jay-hamlin/rpncalculator/README.md

# rpncalculator
RPN Calculator inspired by the HP-97
