jay-hamlin/rpncalculator/Hardware/RPNCalc_BOM_1208.ods

Source: | /Users/jayhamlin/Documents/KiCAD_Projects/RPN_Calc/RPN_calc_TOPsch.sch
Date: | 12/08/20
Tool: | Eeschema (5.1.6-0-10_14)
Generator: | /private/var/folders/gj/cw4xhsdd5xb5fvtbn493dk5w0000gn/T/AppTranslocation/25B9B632-5422-4884-8414-362C2BAEAF93/d/kicad.app/Contents/SharedSupport/plugins/bom_csv_grouped_by_value_with_fp.py
Component Count:
Ref | Qty | Value | Cmp name | Footprint | Description | Manufacturer | MPN | Digikey PN | ordered | buildable qty | $$
C201, C203, C207, C209, C213, C215, C301, C403, C406, C407, C408, C409, C410, C412, C413, C414, C415, C416, C418, C419, C420, C507, C509, | 23 | 100nF | C | C_0603 | CAP CER 0.1UF 25V X7R 0603 | AVX | 06033C104KAT4A | 478-7018-1-ND | 100 | 4.3 | $1.89
C202, C204, C208, C210, C214, C216, C411, C502, | 8 | 1uF | C | C_0603 | CAP CER 1UF 16V X7R 0603 | AVX | 0603YC105KAT4A | 478-10815-1-ND | 50 | 6.3 | $4.08
C205, C206, C401, C402, | 4 | 4.7uF | C_Small | C_0805 | CAP CER 4.7UF 16V X7R 0805 | AVX | 0805YC475KAT2A | 478-5722-1-ND | 25 | 6.3 | $5.40
C404, C405, | 2 | 20pF | C_Small | C_0402 | CAP CER 20PF 50V NP0 0402 | AVX | 04025U200FAT2A | 478-10147-1-ND | 8 | 4.0 | $2.51
C417, C503, C504, C508, | 4 | 10uF | C | C_1206 | CAP CER 10UF 16V X7R 1206 | AVX | 1206YC106KAT2A | 478-5725-1-ND | 22 | 5.5 | $8.61
C501, | 1 | 33uF | CP1_Small | C_Radial_D5.0mm_H11.0mm_P2.00mm | CAP ALUM 33UF 20% 25V RADIAL | Nichicon | UPW1E330MDD | 493-1814-ND | 2 | 2.0 | $2.55
C505, | 1 | 7.0pF | C | C_0402 | CAP CER 7PF 50V NP0 0402 | AVX | 04025A7R0CAT2A | 478-10114-1-ND | 8 | 8.0 | $0.41
C506, | 1 | 33pF | C | C_0402 | CAP CER 33PF 25V C0G/NP0 0402 | AVX | 04023A330JAT2A | 478-12613-1-ND | 8 | 8.0 | $0.30
D1, D2, D3, D4, | 4 | LED | LED | LED_THT_D3.0mm | LED RED DIFFUSED 3MM ROUND T/H | Wurth | 151031SS06000 | 732-5006-ND | 29 | 7.3
D401, D402, D403, | 3 | LED | LED | LED_1206 | LED RED CLEAR 1206 SMD | Lite-On Inc. | LTST-C150CKT | 160-1167-1-ND | 90 | 30.0
D501, | 1 | CDBU0240 | D | D_0603 | DIODE SCHOTTKY 40V 200MA 0603 | Comchip | CDBU0240 | 641-1009-1-ND | 8 | 8.0 | $2.80
F401, F402, | 2 | Polyfuse_Small | Polyfuse_Small | Fuse_1206 | PTC RESET FUSE 13.2V 500MA 1206 | Littlefuse, Inc. | NANOSMDC050F/13.2-2 | NANOSMDC050F/13.2-2CT-ND | 1 | 0.5 |  | buy more
FB401, | 1 | Ferrite_Bead_Small | Ferrite_Bead_Small | L_0805 | FERRITE BEAD 600 OHM 0805 1LN | Vishay | ILBB0805ER601V | 541-2297-1-ND | 8 | 8.0 | $0.75
J201, J202 | 2 | Conn_01x04 | Conn_01x04_FEMALE | PinHeader_1x04_P2.54mm_Vertical FEMALE | CONN HDR 4POS 0.1 GOLD PCB | Sullins | PPPC041LFBN-RC | S7037-ND | 8 | 4.0 | $4.37
J401, J402, | 2 |  | Conn_01x04_MALE | PinHeader_1x04_P2.54mm_Vertical MALE | CONN HEADER VERT 4POS 2.54MM | Wurth | 61300411121 | 732-5317-ND | 8 | 4.0
J203, J204, | 2 | Conn_01x02 | Conn_01x02_FEMALE | PinHeader_1x02_P2.54mm_Vertical FEMALE | CONN HDR 2POS 0.1 GOLD PCB | Sullins | PPPC021LFBN-RC | S7035-ND | 8 | 4.0 | $3.15
J403, J404, | 2 |  | Conn_01x02_Male | PinHeader_1x02_P2.54mm_Vertical MALE | CONN HEADER VERT 2POS 2.54MM | Wurth | 61300211121 | 732-5315-ND | 8 | 4.0
J405, | 1 | Conn_02x03_Odd_Even | Conn_02x03_Odd_Even | PinHeader_2x03_P2.54mm_Vertical MALE | CONN HEADER VERT 6POS 2.54MM | Wurth | 61300621121 | 732-5295-ND | 8 | 8.0
J406, J407, | 2 | USB_B_Micro | USB_B_Micro | USB_Micro-B_Molex-105017-0001 | CONN RCPT USB2.0 MICRO B SMD R/A | Molex | 1050170001 | WM1399CT-ND | 4 | 2.0 | $4.98
J501, | 1 | JST PTH 2.0mm vertical | Conn_01x02_Male | JST_PH_B2B-PH-K_1x02_P2.00mm_Vertical | CONN HEADER VERT 2POS 2MM | JST Sales | B2B-PH-K-S(LF)(SN) | 455-1704-ND | 10 | 10.0 | $0.85
L501, | 1 | 2.2uH | L_Small | L_Bourns-SRN4018 | FIXED IND 2.2UH 2.9A 44 MOHM SMD | Bourns | SRN4018-2R2M | SRN4018-2R2MCT-ND | 4 | 4.0 | $2.20
LD1, LD2, LD3, LD4, LD5, LD6, LD7, LD8, LD9, LD10, LD11, LD12, | 12 | LTP-305HR | LTP-305HR | LTP-305HR_DIP14 | DISPLAY DOT MATRX HER 0.30" 5X7 | Lite-On Inc. | LTP-305HR | 160-1881-ND | 12 | 1.0
Q501, Q503, | 2 | MMBT3906 | 2N3906 | SOT-23 | TRANS PNP 40V 0.2A SOT-23 | MMC | MMBT3906-TP | MMBT3906-TPCT-ND | 8 | 4.0 | $1.18
Q502, | 1 | 2N7002 | 2N7002 | SOT-23 | MOSFET N-CH 60V 115MA SOT-23 | ON Semiconductor | 2N7002 | 2N7002NCT-ND | 20 | 20.0 | $2.63
R402, R403, R404, R405,R504 | 5 | 2.2K | R_Small_US | R_0603 | RES SMD 2.2K OHM 1% 1/10W 0603 | Panasonic | ERJ-3EKF2201V | P2.20KHCT-ND | 90 | 18.0 | $1.30
R205, R206, R207, R208, R408, R409, R421, R422, | 8 | 20R | R_Small_US | R_0402 | RES SMD 20 OHM 1% 1/10W 0402 | Panasonic | ERJ-2RKF20R0X | P20.0LCT-ND | 90 | 11.3 | $0.89
R301, R302, R303, R304, R305, R306, R307, R308, R411, R423, R425, R501, R502, R503, R505,R506, R507, R509,R511, R513 | 20 | 100K | R_Small_US | R_0603 | RES SMD 100K OHM 1% 1/10W 0603 | Yageo | RC0603FR-07100KL | 311-100KHRCT-ND | 100 | 5.0 | $0.85
R401 | 1 | 10K | R_Small_US | R_0603 | RES SMD 10K OHM 1% 1/10W 0603 | Panasonic | ERJ-3EKF1002V | P10.0KHCT-ND | 90 | 90.0 | $1.30
R406, R407, R412, R413, R414, R419, R420, R508, R510 | 9 | 1K | R_Small_US | R_0603 | RES SMD 1K OHM 1% 1/10W 0603 | Panasonic | ERJ-3EKF1001V | P1.00KHCT-ND | 100 | 11.1 | $1.30
R410, | 1 | 240R | R_Small_US | R_0603 | RES SMD 240 OHM 1% 1/10W 0603 | Panasonic | ERJ-3EKF2400V | P240HCT-ND | 90 | 90.0 | $0.32
R427 | 1 | 200K | R_Small_US | R_0603 | RES SMD 200K OHM 1% 1/10W 0603 | Panasonic | ERJ-3EKF2003V | P200KHCT-ND | 100 | 100.0
R512 | 1 | 499K,1% | R_Small_US | R_0603 | RES SMD 499K OHM 1% 1/10W 0603 | Panasonic | ERJ-3EKF4993V | P499KHCT-ND | 20 | 20.0
R415 | 1 | 549K,1% | R_Small_US | R_0603 | RES SMD 549K OHM 1% 1/10W 0603 | Panasonic | ERJ-3EKF5493V | P549KHCT-ND | 100 | 100.0 | $0.80
R424, R426 | 2 | 604K,1% | R_Small_US | R_0603 | RES SMD 604K OHM 1% 1/10W 0603 | Panasonic | ERJ-3EKF6043V | P604KHCT-ND | 100 | 50.0
R417 | 1 | 1.00M,1% | R_Small_US | R_0603 | RES SMD 1M OHM 1% 1/4W 0603 | Panasonic | ERJ-PA3F1004V | P1.0MBYCT-ND | 100 | 100.0 | $1.13
R416, R418 | 2 | 2.00M,1% | R_Small_US | R_0603 | RES SMD 2M OHM 1% 1/10W 0603 | Panasonic | ERJ-3EKF2004V | P2.00MHCT-ND | 100 | 50.0
RV401, | 1 | 50K, linear | R_POT_Small | Potentiometer_Bourns_3266Y_Vertical | THUMBWHEEL POT 50K OHM 0.5W SIDE | Bourns | 3352W-1-503LF | 3352W-503LF-ND | 2 | 2.0 | $10.75
SW1_BASE1, SW2_DSP1, SW3_C1, SW4_D1, SW5_E1, SW6_F1, SW7_/1, SW8_SEND1, SW9_CHS1, SW10_B1, SW11_7, SW12_8, SW13_9, SW14_X1, SW15_COPY1, SW16_ROL1, SW17_A1, SW18_4, SW19_5, SW20_6, SW21_-1, SW22_PASTE1, SW23_X-Y1, SW24_MOD1, SW25_1, SW26_2, SW27_3, SW28_+1, SW29_func1, SW30_R1, SW31_<-1, SW32_0, SW33_.1, SW34_ENTER1, | 34 | TL1105SPF | TL1105SPF | Button_Switch_THT:SW_PUSH_TL1105 | SWITCH TACTILE SPST-NO 0.05A 12V | E-Switch | TL1105SPF100Q | EG2502-ND | 60
SW501, | 1 | 1-1825027-1 | 1-1825027-1 | Button_Switch_THT:SW_Tactile_SPST_Angled_PTS645Vx58-2LFS | SWITCH TACTILE SPST-NO 0.05A 24V | TE | 1-1825027-1 | 450-1658-ND | 2 | 2.0
TH501, | 1 | 10K, NTC | Thermistor_NTC | R_0603 | THERMISTOR NTC 10KOHM 3477K 0603 | Vishay | NTHS0603N02N1002JE | 541-1107-1-ND | 2 | 2.0
U1, U2, U3, U4, U5, U6, | 6 | IS31FL3730-QFN24 | IS31FL3730-QFN24 | QFN-24-1EP_4x4mm_P0.5mm_EP2.7x2.7mm | IC MATRIX LED DRIVER AUDIO 24QFN | Lumissil | IS31FL3730-QFLS2-TR | 706-1479-1-ND | 12 | 2.0
U301, | 1 | TCA8418RTWR | TCA8418RTWR | WQFN-24-1EP_4x4mm_P0.5mm_EP2.6x2.6mm | IC INTERFACE SPECIALIZED 24WQFN | TI | TCA8418RTWR | 296-25223-1-ND | 2 | 2.0
U401, | 1 | STM32F070CBTx | STM32F070CBTx | LQFP-48_7x7mm_P0.5mm | IC MCU 32BIT 32KB FLASH 48LQFP | ST Micro | STM32F070C6T6TR | 497-18744-1-ND | 2 | 2.0
U402, U403, | 2 | W25Q128JVS | W25Q128JVS | SOIC-8_5.23x5.23mm_P1.27mm | IC FLASH 128M SPI 133MHZ 8SOIC | Winbond | W25Q128JVSIQ TR | W25Q128JVSIQCT-ND | 4 | 2.0
U404, | 1 | FT231XS | FT231XS | SSOP-20_3.9x8.7mm_P0.635mm | IC USB SERIAL FULL UART 20SSOP | FTDI | FT231XS-R | 768-1129-1-ND | 1 | 1.0 | 1
U405, | 1 | MCP6422T-E/SN | MCP6422T-E/SN | SOIC-8_3.9x4.9mm_P1.27mm | IC OPAMP GP 2 CIRCUIT 8SOIC | Microchip | MCP6422T-E/SN | MCP6422T-E/SNCT-ND | 10 | 10.0 | 3
U501, | 1 | MCP73833T-FCI_MF | MCP73833T-FCI_MF | DFN-10-1EP_3x3mm_P0.5mm_EP1.7x2.5mm | IC LI-ION/LI-POLY CTRLR 10DFN | Microchip | MCP73833T-FCI/MF | MCP73833T-FCI/MFCT-ND | 2 | 2.0
U502, | 1 | LM3671MF | LM3671MF | TSOT-23-5 | IC REG BUCK ADJ 600MA SOT23-5 | TI | LM3671MF-ADJ/NOPB | LM3671MF-ADJ/NOPBCT-ND | 2 | 2.0
Y401, | 1 | 8MHz(12pF) | Crystal | HC49-SD | CRYSTAL 8.0000MHZ 12PF SMD | TXC | 9C-8.000MAAE-T | 887-2473-1-ND | 2 | 2.0
 |  |  |  |  |  |  |  |  | Total=
