jay-hamlin/rpncalculator/(list of files, cad)

Other CAD files:
Mechanical/rpnkeys2.scad
Mechanical/rpnkeys_1230am.scad
Mechanical/rpnkeys_frame.scad
