jay-hamlin/rpncalculator/Hardware/RPN_calc_TOPsch.pdf

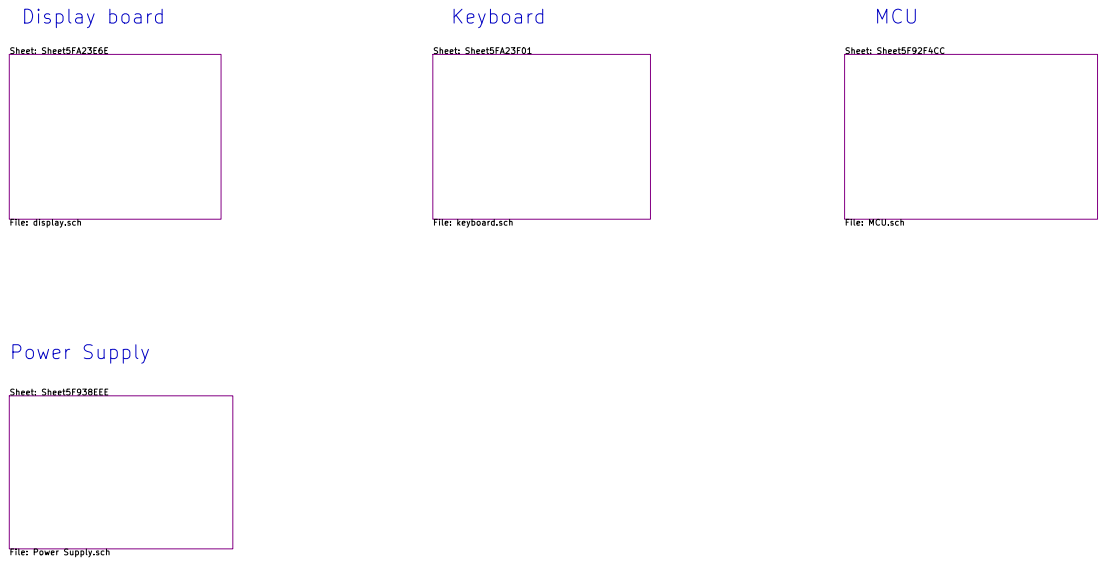
[picture p1: page 1]

File: MCU.sch Sheet: Sheet5F938EEE

File: Power Supply.sch

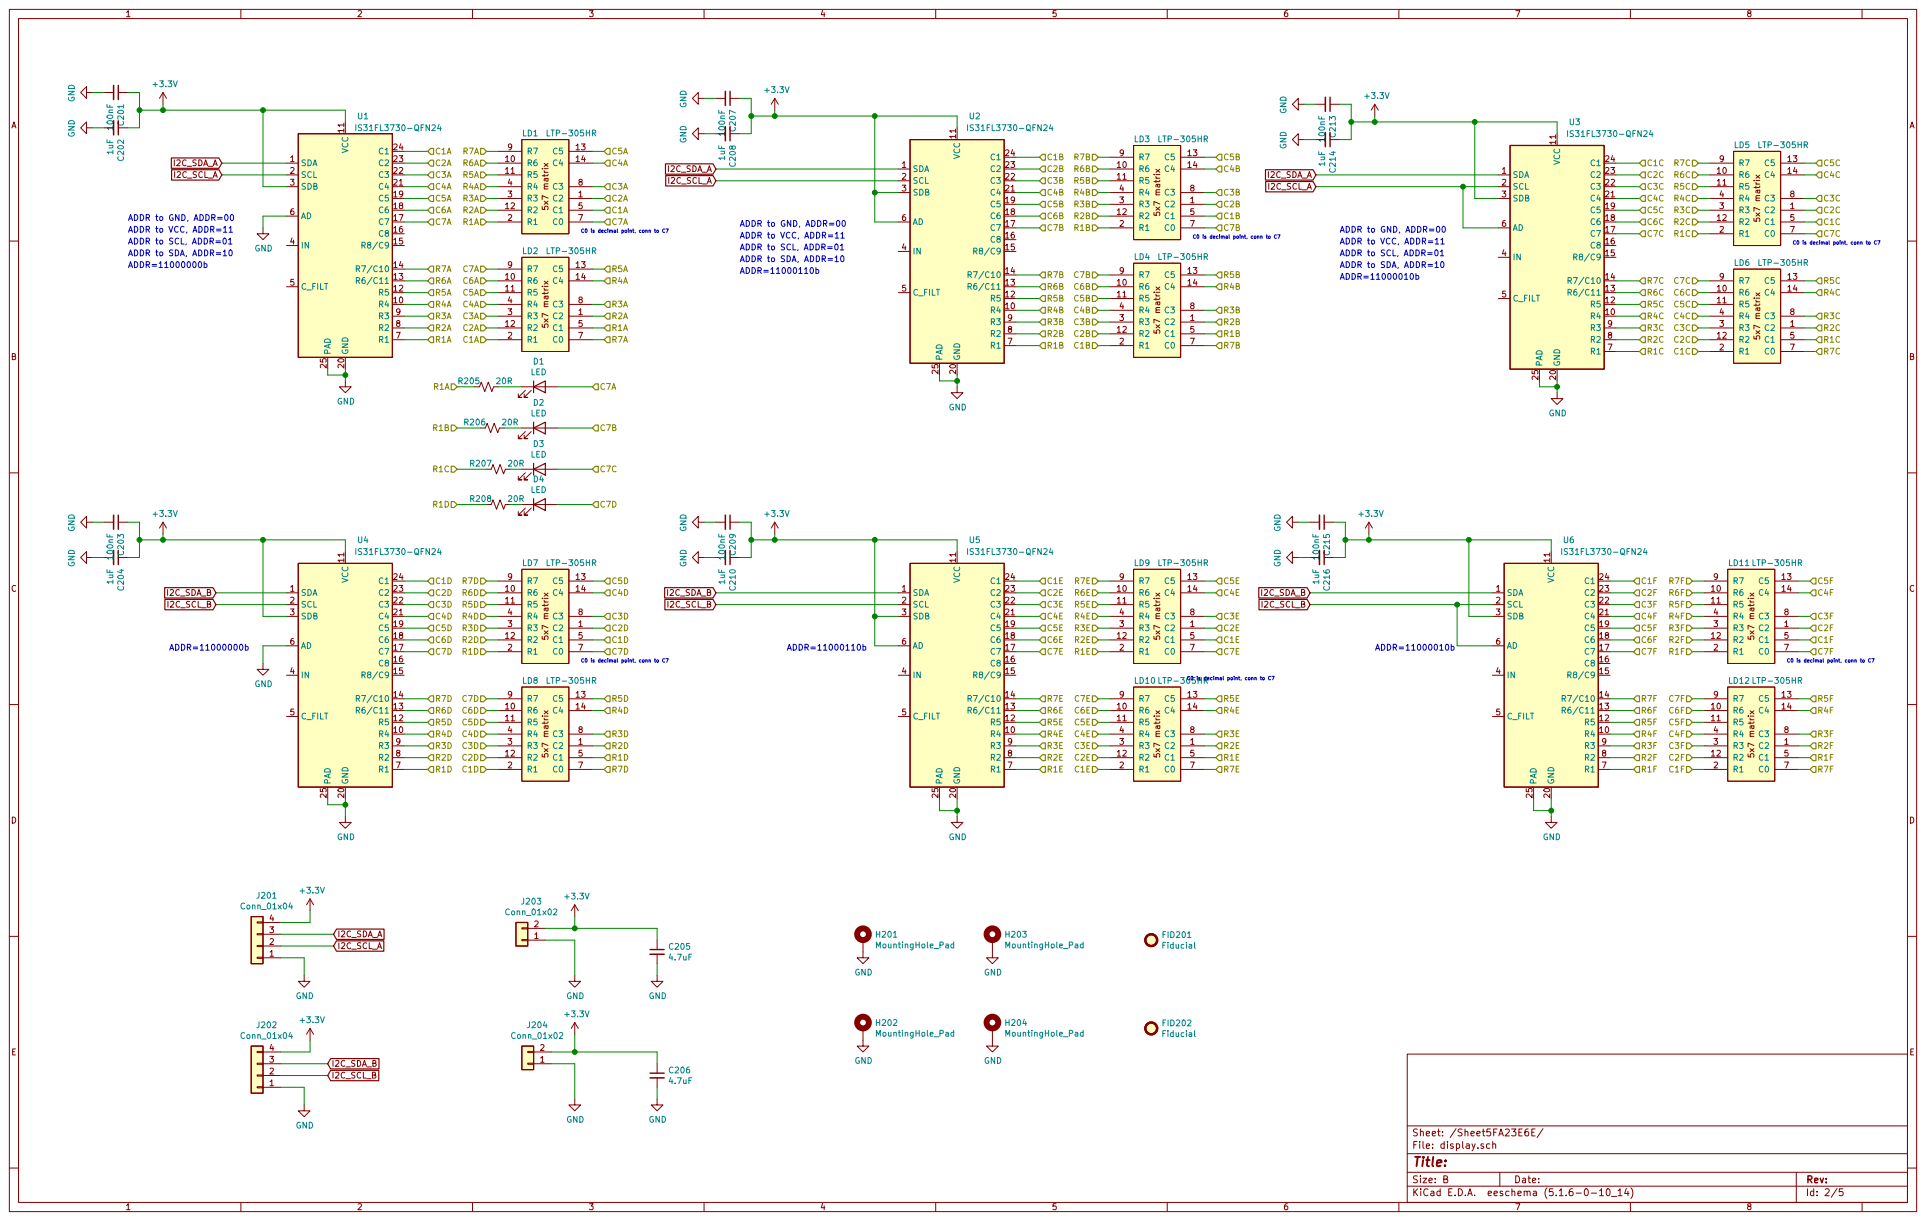
[picture p2: page 2]

ADDR to SCL, ADDR=01 ADDR to GND, ADDR=00
ADDR to SDA, ADDR=10 ADDR to VCC, ADDR=11 ADDR to SCL, ADDR=01

C0 is decimal point, conn to C7

File: display.sch Sheet: /Sheet5FA23E6E/

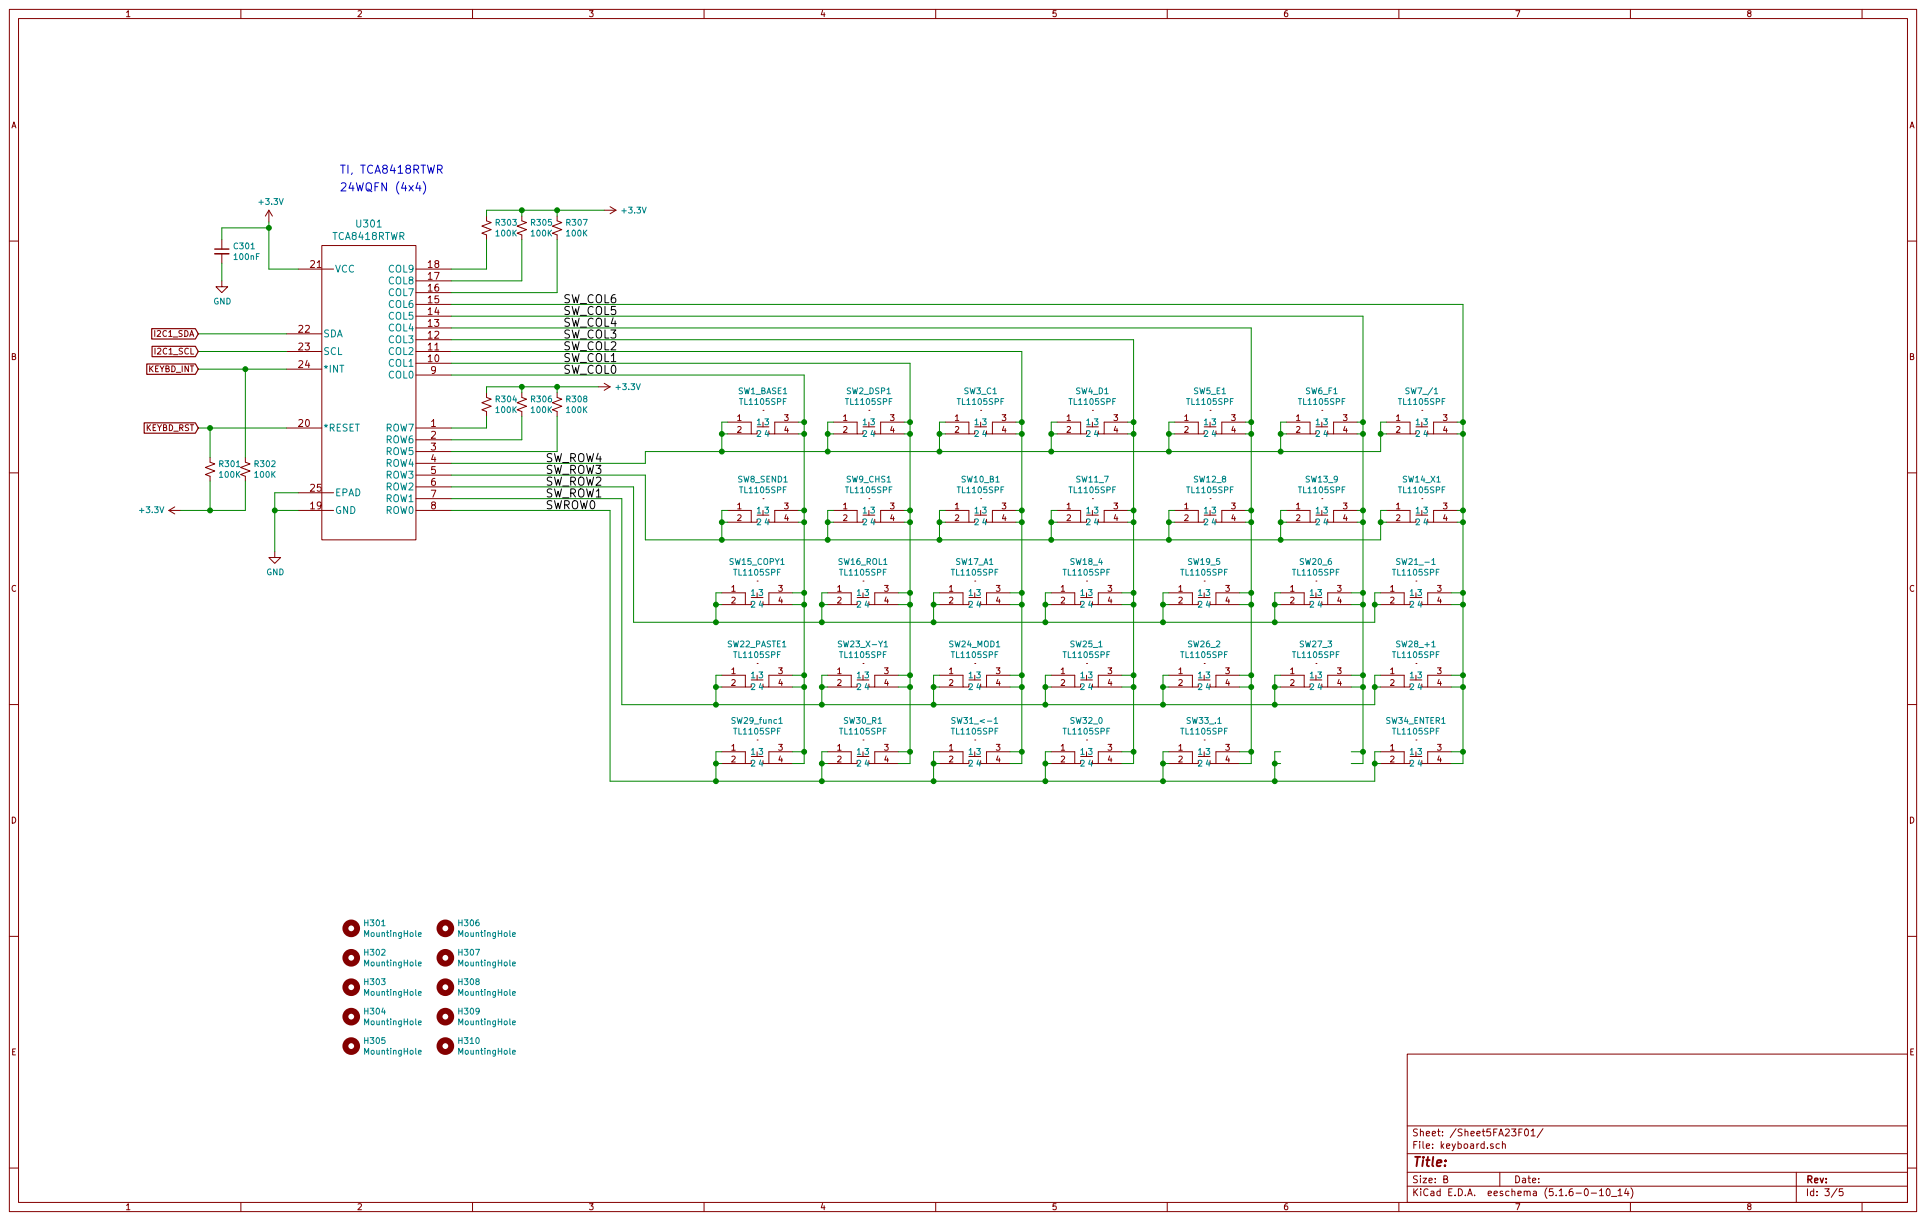
[picture p3: page 3]

SW_COL5
SW_COL4
SW_COL3
SW_COL2
SW_COL1
SW_COL0

4 SW9_CHS1 TL1105SPF 1 3 | 4 SW10_B1 TL1105SPF 1 3 | 4 SW11_7 TL1105SPF 1 3 | 4 SW12_8 TL1105SPF 1 3 | 4 SW13_9 TL1105SPF 1 3

File: keyboard.sch Sheet: /Sheet5FA23F01/

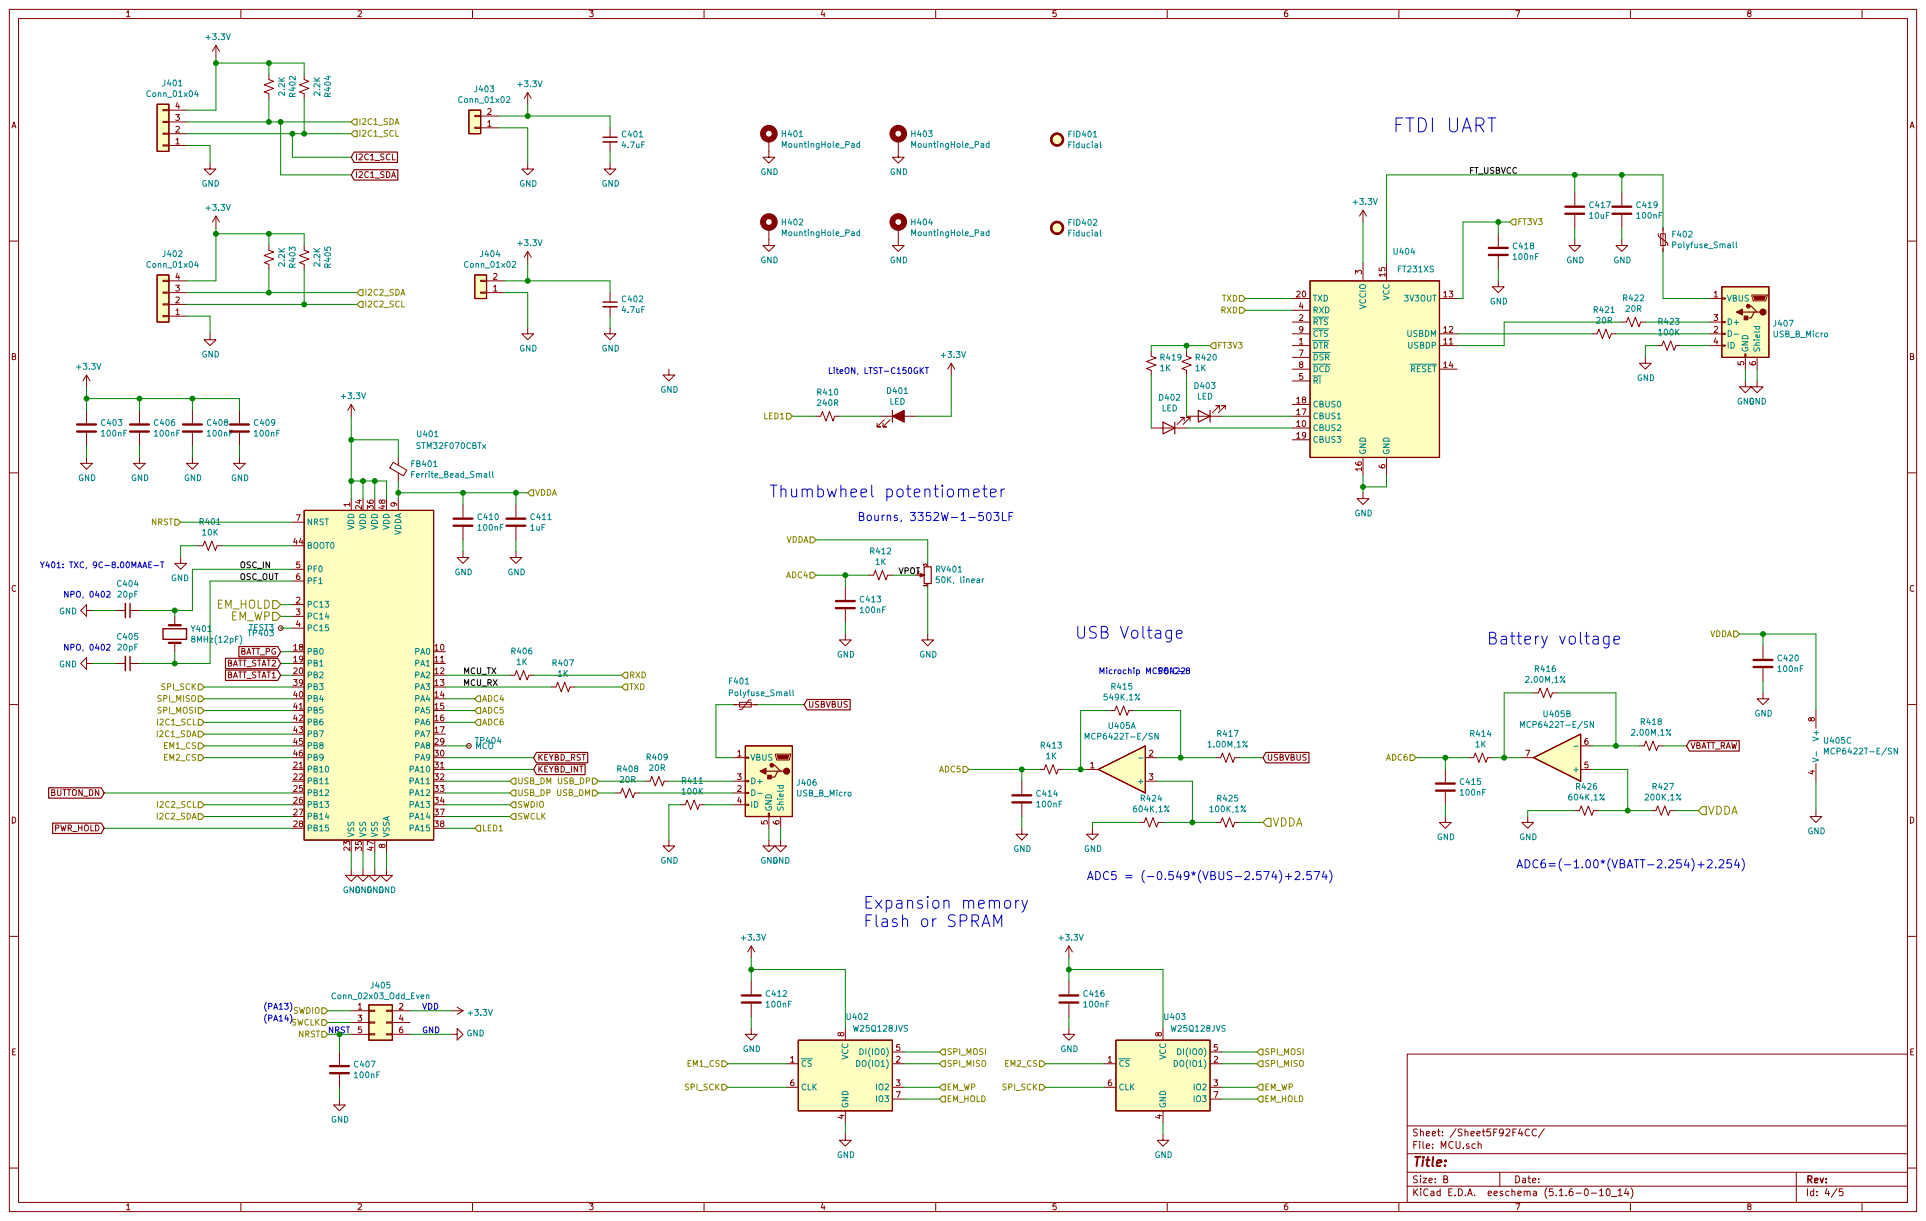
[picture p4: page 4]

1 PA0 10 PA1 11 PA2 12 PA3 13 PA4 14 PA5 15 PA6 16 PA7 17 PB0 18 PB1 19 PC13 2 PB2 20 PB10 21 PB11 22 VSS 23 VDD 24 PB12 25 PB13 26 PB14 27 PB15 28 PA8 29 PC14 3 PA9 30 PA10 31 PA11 32 PA12 33 PA13 34 VSS 35 VDD 36 PA14 37 PA15 38 PB3 39 PC15 4 PB4 40 PB5 41 PB6 42 PB7 43 BOOT0 44 PB8 45 PB9 46 VSS 47 VDD 48 PF0 5 PF1 6 NRST 7 VSSA

Id: 4/5 Title: File: MCU.sch Sheet: /Sheet5F92F4CC/

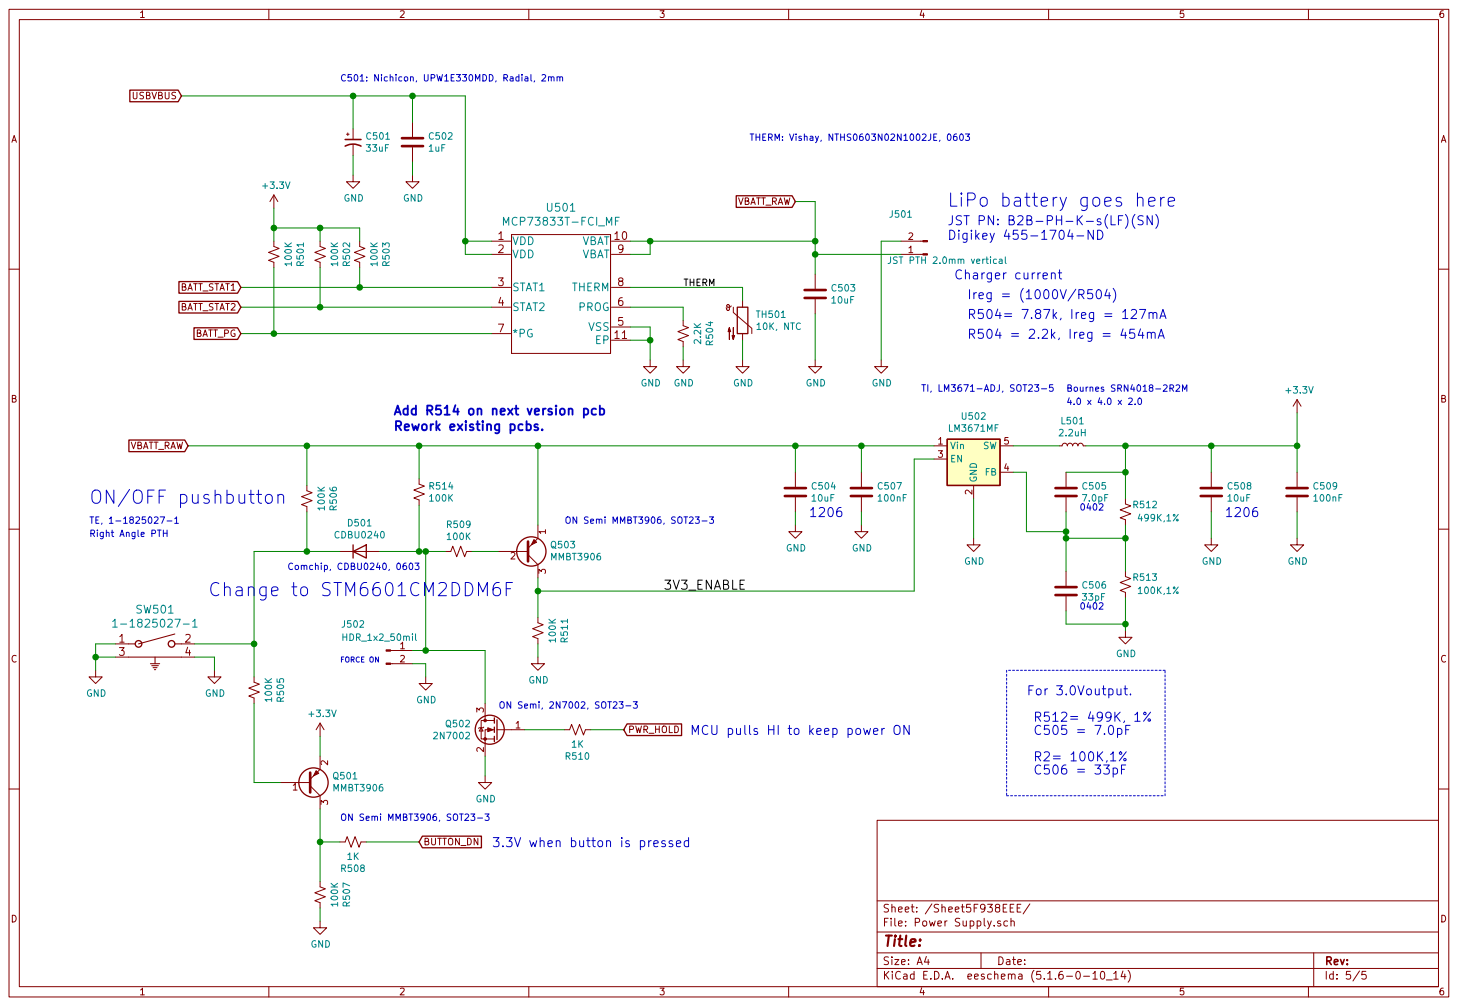
[picture p5: page 5]

JST PN: B2B-PH-K-s(LF)(SN)
Digikey 455-1704-ND

+3.3V GND
Add R514 on next version pcb
Rework existing pcbs.

0402 TI, LM3671-ADJ, SOT23-5 MCU pulls HI to keep power ON

FORCE ON ON/OFF pushbutton

3.3V when button is pressed
