jay-hamlin/rpncalculator/Hardware/RPN_Calc.kicad_pcb

## KiCad design Hardware/RPN_Calc.kicad_pcb (2020-12-23)

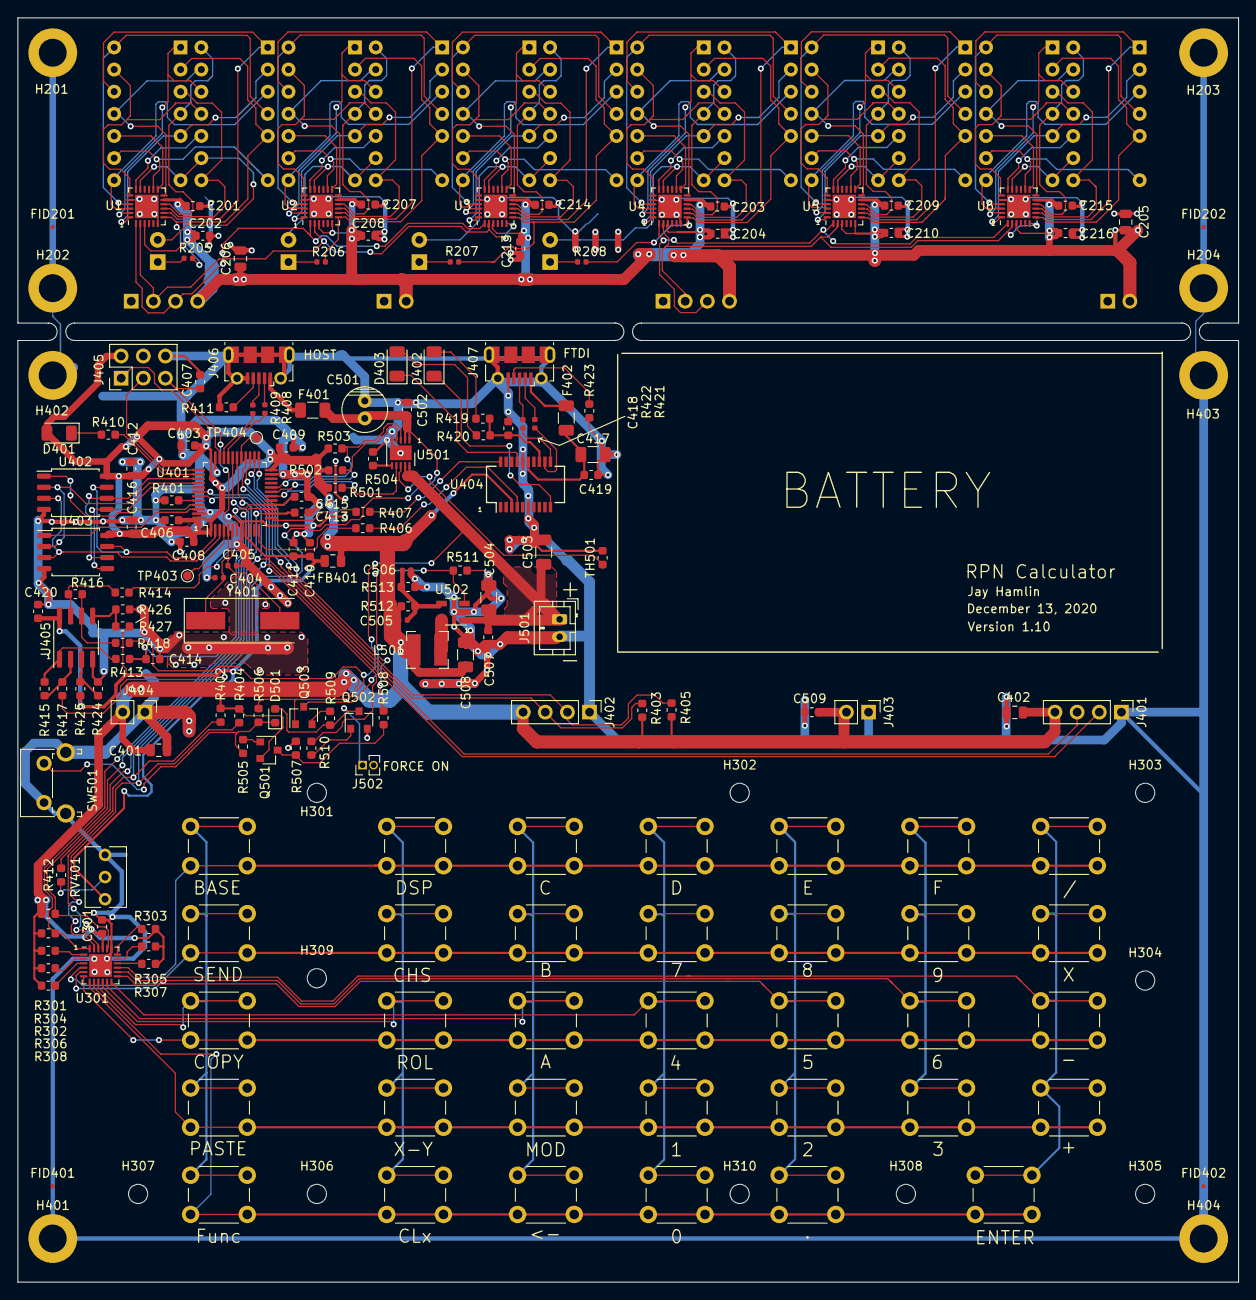
[picture p6: board RPN_Calc.kicad_pcb from above]

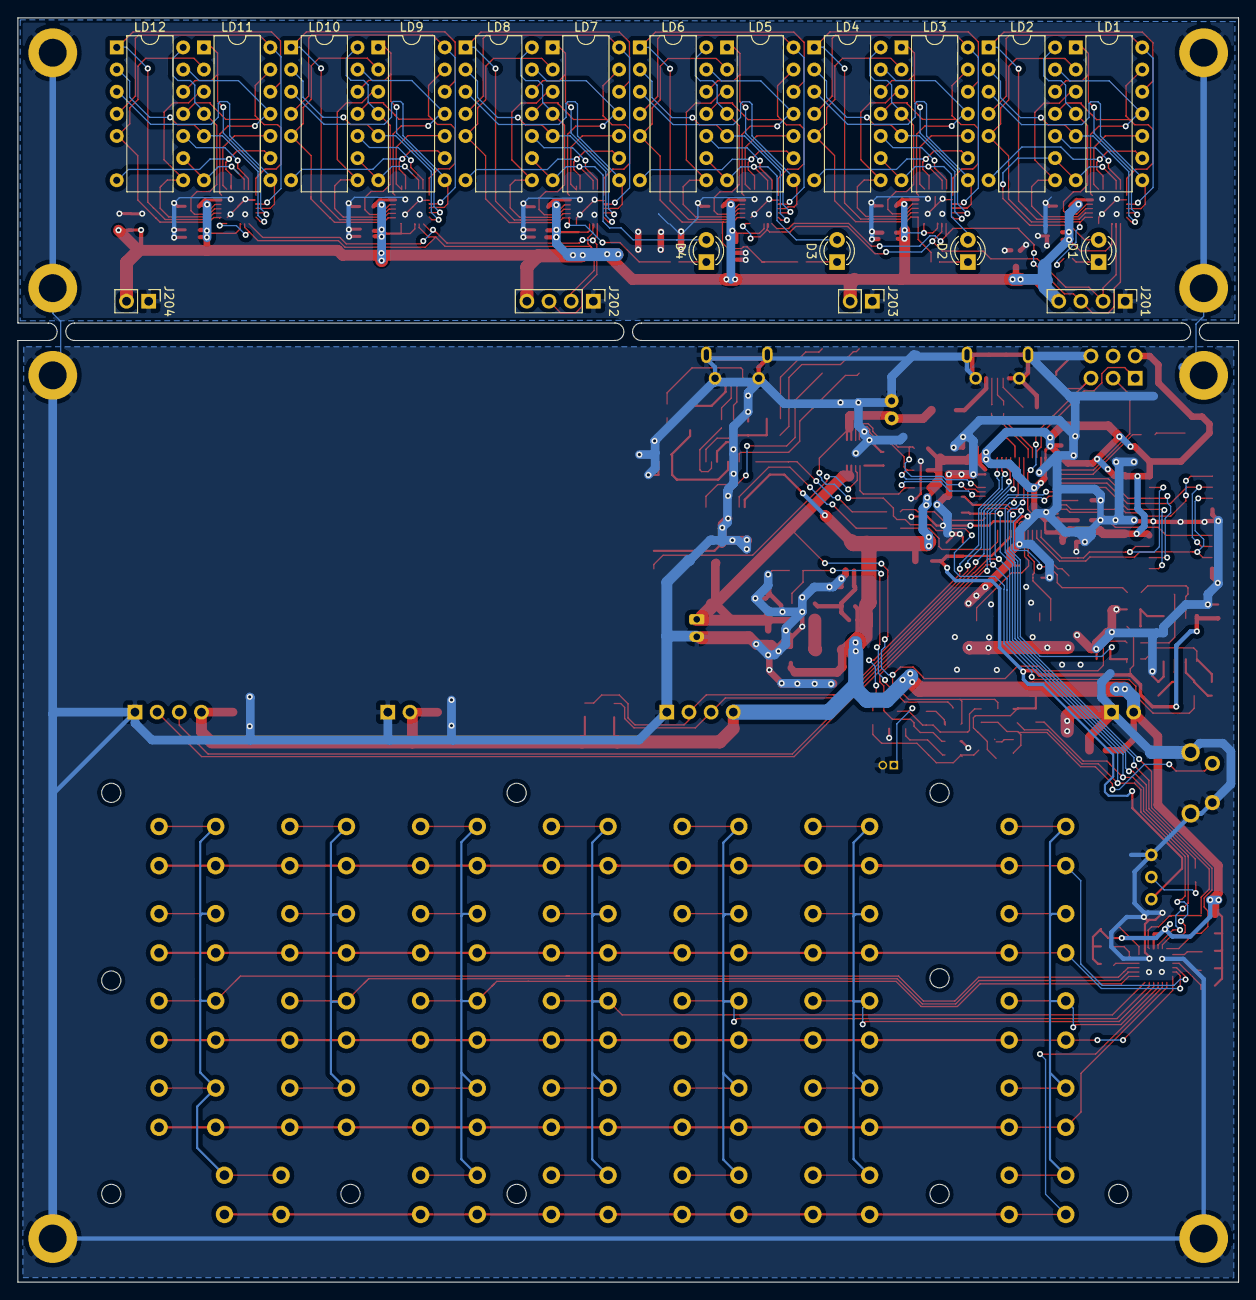
[picture p7: board RPN_Calc.kicad_pcb from below]

Board: 2 copper layers, 140.0 x 145.0 mm, 212 parts (20 on the bottom side), 186 nets.

Parts:
0, 1, 2, 3, 4, 5, 6, 7, 8, 9, .: TL1105SPF; SW_PUSH_TL1105
+: TL1105SPF; SW_PUSH_TL1105
-: TL1105SPF; SW_PUSH_TL1105
/: TL1105SPF; SW_PUSH_TL1105
<-: TL1105SPF; SW_PUSH_TL1105
A: TL1105SPF; SW_PUSH_TL1105
B: TL1105SPF; SW_PUSH_TL1105
BASE: TL1105SPF; SW_PUSH_TL1105
C: TL1105SPF; SW_PUSH_TL1105
C201, C203, C207, C209, C213, C215, C301, C403, C406, C407, C408, C409, C410, C412, C413, C414, C415, C416, C418, C419, C420, C507, C509: 100nF; C_0603_1608Metric
C202, C204, C208, C210, C214, C216, C411, C502: 1uF; C_0603_1608Metric
C205, C206, C401, C402: 4.7uF; C_0805_2012Metric
C404, C405: 20pF; C_0402_1005Metric
C417, C503, C504, C508: 10uF; C_1206_3216Metric
C501: 33uF; C_Radial_D5.0mm_H11.0mm_P2.00mm
C505: 7.0pF; C_0402_1005Metric
C506: 33pF; C_0402_1005Metric
CHS: TL1105SPF; SW_PUSH_TL1105
CLx: TL1105SPF; SW_PUSH_TL1105
COPY: TL1105SPF; SW_PUSH_TL1105
D: TL1105SPF; SW_PUSH_TL1105
D1, D2, D3, D4: LED; LED_D3.0mm
D401: LED_GREEN; LED_1206_3216Metric
D402, D403: LED; LED_1206_3216Metric
D501: CDBU0240; D_0603_1608Metric
DSP: TL1105SPF; SW_PUSH_TL1105
E: TL1105SPF; SW_PUSH_TL1105
ENTER: TL1105SPF; SW_PUSH_TL1105
F: TL1105SPF; SW_PUSH_TL1105
F401, F402: Polyfuse_Small; Fuse_1206_3216Metric
FB401: Ferrite_Bead_Small; L_0805_2012Metric
FID201, FID202, FID401, FID402: Fiducial; Fiducial_0.5mm_Mask1mm
Func: TL1105SPF; SW_PUSH_TL1105
H201, H202, H203, H204, H401, H402, H403, H404: MountingHole_Pad; MountingHole_3.2mm_M3_DIN965_Pad
H301, H302, H303, H304, H305, H306, H307, H308, H309, H310: MountingHole; MountingHole_2.2mm_M2
J201, J202, J401, J402: Conn_01x04; PinHeader_1x04_P2.54mm_Vertical
J203, J204, J403, J404: Conn_01x02; PinHeader_1x02_P2.54mm_Vertical
J405: Conn_02x03_Odd_Even; PinHeader_2x03_P2.54mm_Vertical
J406, J407: USB_B_Micro; USB_Micro-B_Molex-105017-0001
J501: JST PTH 2.0mm vertical; JST_PH_B2B-PH-K_1x02_P2.00mm_Vertical
J502: HDR_1x2_50mil; PinHeader_1x02_P1.27mm_Vertical
L501: 2.2uH; L_Bourns-SRN4018
LD1, LD2, LD3, LD4, LD5, LD6, LD7, LD8, LD9, LD10, LD11, LD12: LTP-305HR; DIP-14_LTP-305HR
MOD: TL1105SPF; SW_PUSH_TL1105
PASTE: TL1105SPF; SW_PUSH_TL1105
Q501, Q503: MMBT3906; SOT-23
Q502: 2N7002; SOT-23
R205, R206, R207, R208, R408, R409, R421, R422: 20R; R_0402_1005Metric
R301, R302, R303, R304, R305, R306, R307, R308, R411, R423, R501, R502, R503, R505, R506, R507, R509, R511: 100K; R_0603_1608Metric
R401: 10K; R_0603_1608Metric
R402, R403, R404, R405: 2.2K; R_0603_1608Metric
R406, R407, R412, R413, R414, R419, R420, R508, R510: 1K; R_0603_1608Metric
R410: 240R; R_0603_1608Metric
R415: 549K,1%; R_0603_1608Metric
R416, R418: 2.00M,1%; R_0603_1608Metric
R417: 1.00M,1%; R_0603_1608Metric
R424, R426: 604K,1%; R_0603_1608Metric
R425, R513: 100K,1%; R_0603_1608Metric
R427: 200K,1%; R_0603_1608Metric
R504: 7.8K,1%; R_0603_1608Metric
R512: 500K,1%; R_0603_1608Metric
ROL: TL1105SPF; SW_PUSH_TL1105
RV401: 50K, linear; Potentiometer_Bourns_3266Y_Vertical
SEND: TL1105SPF; SW_PUSH_TL1105
SW501: 1-1825027-1; SW_Tactile_SPST_Angled_PTS645Vx58-2LFS
TH501: 10K, NTC; R_0603_1608Metric
TP403: TEST3; TestPoint_Pad_D1.0mm
TP404: MCO; TestPoint_Pad_D1.0mm
U1, U2, U3, U4, U5, U6: IS31FL3730-QFN24; QFN-24-1EP_4x4mm_P0.5mm_EP2.7x2.7mm
U301: TCA8418RTWR; WQFN-24-1EP_4x4mm_P0.5mm_EP2.6x2.6mm
U401: STM32F070CBTx; LQFP-48_7x7mm_P0.5mm
U402, U403: W25Q128JVS; SOIC-8_5.23x5.23mm_P1.27mm
U404: FT231XS; SSOP-20_3.9x8.7mm_P0.635mm
U405: MCP6422T-E/SN; SOIC-8_3.9x4.9mm_P1.27mm
U501: MCP73833T-FCI_MF; DFN-10-1EP_3x3mm_P0.5mm_EP1.7x2.5mm
U502: LM3671MF; TSOT-23-5
X: TL1105SPF; SW_PUSH_TL1105
X-Y: TL1105SPF; SW_PUSH_TL1105
Y401: 8MHz(12pF); Crystal_SMD_HC49-SD

Connections:
+3V3: C201.1, C202.1, C203.1, C204.1, C205.1, C206.1, C207.1, C208.1, C209.1, C210.1, C213.1, C214.1, C215.1, C216.1, C301.1, C401.1, C402.1, C403.1, C406.1, C408.1, C409.1, C412.1, C416.1, C505.1, C508.1, C509.1, D401.2, FB401.1, J201.4, J202.4, J203.2, J204.2, J401.4, J402.4, J403.2, J404.2, J405.2, L501.2, Q501.2, R301.2, R302.2, R303.1, R304.1, R305.1, R306.1, R307.1, R308.1, R402.2, R403.2, R404.2, R405.2, R501.2, R502.2, R503.2, R512.2, U1.3, U1.11, U2.3, U2.6, U2.11, U3.3, U3.11, U4.3, U4.11, U5.3, U5.6, U5.11, U6.3, U6.11, U301.21, U401.1, U401.24, U401.36, U401.48, U402.8, U403.8, U404.3
/Sheet5F92F4CC/ADC4: C413.1, R412.2, U401.14
/Sheet5F92F4CC/ADC5: C414.1, R413.2, U401.15
/Sheet5F92F4CC/ADC6: C415.1, R414.2, U401.16
/Sheet5F92F4CC/EM1_CS: U401.45, U402.1
/Sheet5F92F4CC/EM2_CS: U401.46, U403.1
/Sheet5F92F4CC/EM_HOLD: U401.2, U402.7, U403.7
/Sheet5F92F4CC/EM_WP: U401.3, U402.3, U403.3
/Sheet5F92F4CC/FT3V3: C418.1, R419.2, R420.2, U404.13
/Sheet5F92F4CC/FT_USBVCC: C417.1, C419.1, F402.1, U404.15
/Sheet5F92F4CC/I2C2_SCL: J402.2, R405.1, U401.26
/Sheet5F92F4CC/I2C2_SDA: J402.3, R403.1, U401.27
/Sheet5F92F4CC/LED1: R410.2, U401.38
/Sheet5F92F4CC/MCU_RX: R407.2, U401.13
/Sheet5F92F4CC/MCU_TX: R406.2, U401.12
/Sheet5F92F4CC/NRST: C407.1, J405.5, U401.7
/Sheet5F92F4CC/OSC_IN: C404.1, U401.5, Y401.1
/Sheet5F92F4CC/OSC_OUT: C405.1, U401.6, Y401.2
/Sheet5F92F4CC/RXD: R406.1, U404.4
/Sheet5F92F4CC/SPI_MISO: U401.40, U402.2, U403.2
/Sheet5F92F4CC/SPI_MOSI: U401.41, U402.5, U403.5
/Sheet5F92F4CC/SPI_SCK: U401.39, U402.6, U403.6
/Sheet5F92F4CC/SWCLK: J405.3, U401.37
/Sheet5F92F4CC/SWDIO: J405.1, U401.34
/Sheet5F92F4CC/TXD: R407.1, U404.20
/Sheet5F92F4CC/USB_DM: R408.2, U401.32
/Sheet5F92F4CC/USB_DP: R409.2, U401.33
/Sheet5F92F4CC/VDDA: C410.1, C411.1, C420.1, FB401.2, R425.1, R427.1, RV401.3, U401.9, U405.8
/Sheet5F92F4CC/VPOT: R412.1, RV401.2
/Sheet5F938EEE/3V3_ENABLE: Q503.3, R511.2, U502.3
/Sheet5F938EEE/THERM: TH501.1, U501.8
/Sheet5FA23E6E/C1A: LD1.5, LD2.2, U1.24
/Sheet5FA23E6E/C1B: LD3.5, LD4.2, U2.24
/Sheet5FA23E6E/C1C: LD5.5, LD6.2, U3.24
/Sheet5FA23E6E/C1D: LD7.5, LD8.2, U4.24
/Sheet5FA23E6E/C1E: LD9.5, LD10.2, U5.24
/Sheet5FA23E6E/C1F: LD11.5, LD12.2, U6.24
/Sheet5FA23E6E/C2A: LD1.1, LD2.12, U1.23
/Sheet5FA23E6E/C2B: LD3.1, LD4.12, U2.23
/Sheet5FA23E6E/C2C: LD5.1, LD6.12, U3.23
/Sheet5FA23E6E/C2D: LD7.1, LD8.12, U4.23
/Sheet5FA23E6E/C2E: LD9.1, LD10.12, U5.23
/Sheet5FA23E6E/C2F: LD11.1, LD12.12, U6.23
/Sheet5FA23E6E/C3A: LD1.8, LD2.3, U1.22
/Sheet5FA23E6E/C3B: LD3.8, LD4.3, U2.22
/Sheet5FA23E6E/C3C: LD5.8, LD6.3, U3.22
/Sheet5FA23E6E/C3D: LD7.8, LD8.3, U4.22
/Sheet5FA23E6E/C3E: LD9.8, LD10.3, U5.22
/Sheet5FA23E6E/C3F: LD11.8, LD12.3, U6.22
/Sheet5FA23E6E/C4A: LD1.14, LD2.4, U1.21
/Sheet5FA23E6E/C4B: LD3.14, LD4.4, U2.21
/Sheet5FA23E6E/C4C: LD5.14, LD6.4, U3.21
/Sheet5FA23E6E/C4D: LD7.14, LD8.4, U4.21
/Sheet5FA23E6E/C4E: LD9.14, LD10.4, U5.21
/Sheet5FA23E6E/C4F: LD11.14, LD12.4, U6.21
/Sheet5FA23E6E/C5A: LD1.13, LD2.11, U1.19
/Sheet5FA23E6E/C5B: LD3.13, LD4.11, U2.19
/Sheet5FA23E6E/C5C: LD5.13, LD6.11, U3.19
/Sheet5FA23E6E/C5D: LD7.13, LD8.11, U4.19
/Sheet5FA23E6E/C5E: LD9.13, LD10.11, U5.19
/Sheet5FA23E6E/C5F: LD11.13, LD12.11, U6.19
/Sheet5FA23E6E/C6A: LD2.10, U1.18
/Sheet5FA23E6E/C6B: LD4.10, U2.18
/Sheet5FA23E6E/C6C: LD6.10, U3.18
/Sheet5FA23E6E/C6D: LD8.10, U4.18
/Sheet5FA23E6E/C6E: LD10.10, U5.18
/Sheet5FA23E6E/C6F: LD12.10, U6.18
/Sheet5FA23E6E/C7A: D1.2, LD1.7, LD2.9, U1.17
/Sheet5FA23E6E/C7B: D2.2, LD3.7, LD4.9, U2.17
/Sheet5FA23E6E/C7C: D3.2, LD5.7, LD6.9, U3.17
/Sheet5FA23E6E/C7D: D4.2, LD7.7, LD8.9, U4.17
/Sheet5FA23E6E/C7E: LD9.7, LD10.9, U5.17
/Sheet5FA23E6E/C7F: LD11.7, LD12.9, U6.17
/Sheet5FA23E6E/R1A: LD1.2, LD2.5, R205.2, U1.7
/Sheet5FA23E6E/R1B: LD3.2, LD4.5, R206.2, U2.7
/Sheet5FA23E6E/R1C: LD5.2, LD6.5, R207.2, U3.7
/Sheet5FA23E6E/R1D: LD7.2, LD8.5, R208.2, U4.7
/Sheet5FA23E6E/R1E: LD9.2, LD10.5, U5.7
/Sheet5FA23E6E/R1F: LD11.2, LD12.5, U6.7
/Sheet5FA23E6E/R2A: LD1.12, LD2.1, U1.8
/Sheet5FA23E6E/R2B: LD3.12, LD4.1, U2.8
/Sheet5FA23E6E/R2C: LD5.12, LD6.1, U3.8
/Sheet5FA23E6E/R2D: LD7.12, LD8.1, U4.8
/Sheet5FA23E6E/R2E: LD9.12, LD10.1, U5.8
/Sheet5FA23E6E/R2F: LD11.12, LD12.1, U6.8
/Sheet5FA23E6E/R3A: LD1.3, LD2.8, U1.9
/Sheet5FA23E6E/R3B: LD3.3, LD4.8, U2.9
/Sheet5FA23E6E/R3C: LD5.3, LD6.8, U3.9
/Sheet5FA23E6E/R3D: LD7.3, LD8.8, U4.9
/Sheet5FA23E6E/R3E: LD9.3, LD10.8, U5.9
/Sheet5FA23E6E/R3F: LD11.3, LD12.8, U6.9
/Sheet5FA23E6E/R4A: LD1.4, LD2.14, U1.10
/Sheet5FA23E6E/R4B: LD3.4, LD4.14, U2.10
/Sheet5FA23E6E/R4C: LD5.4, LD6.14, U3.10
/Sheet5FA23E6E/R4D: LD7.4, LD8.14, U4.10
/Sheet5FA23E6E/R4E: LD9.4, LD10.14, U5.10
/Sheet5FA23E6E/R4F: LD11.4, LD12.14, U6.10
/Sheet5FA23E6E/R5A: LD1.11, LD2.13, U1.12
/Sheet5FA23E6E/R5B: LD3.11, LD4.13, U2.12
/Sheet5FA23E6E/R5C: LD5.11, LD6.13, U3.12
/Sheet5FA23E6E/R5D: LD7.11, LD8.13, U4.12
/Sheet5FA23E6E/R5E: LD9.11, LD10.13, U5.12
/Sheet5FA23E6E/R5F: LD11.11, LD12.13, U6.12
/Sheet5FA23E6E/R6A: LD1.10, U1.13
/Sheet5FA23E6E/R6B: LD3.10, U2.13
/Sheet5FA23E6E/R6C: LD5.10, U3.13
/Sheet5FA23E6E/R6D: LD7.10, U4.13
/Sheet5FA23E6E/R6E: LD9.10, U5.13
/Sheet5FA23E6E/R6F: LD11.10, U6.13
/Sheet5FA23E6E/R7A: LD1.9, LD2.7, U1.14
/Sheet5FA23E6E/R7B: LD3.9, LD4.7, U2.14
/Sheet5FA23E6E/R7C: LD5.9, LD6.7, U3.14
/Sheet5FA23E6E/R7D: LD7.9, LD8.7, U4.14
/Sheet5FA23E6E/R7E: LD9.9, LD10.7, U5.14
/Sheet5FA23E6E/R7F: LD11.9, LD12.7, U6.14
/Sheet5FA23F01/SWROW0: 0.1, 0.2, ..1, ..2, <-.1, <-.2, CLx.1, CLx.2, ENTER.1, ENTER.2, Func.1, Func.2, U301.8
/Sheet5FA23F01/SW_COL0: BASE.3, BASE.4, COPY.3, COPY.4, Func.3, Func.4, PASTE.3, PASTE.4, SEND.3, SEND.4, U301.9
/Sheet5FA23F01/SW_COL1: CHS.3, CHS.4, CLx.3, CLx.4, DSP.3, DSP.4, ROL.3, ROL.4, U301.10, X-Y.3, X-Y.4
/Sheet5FA23F01/SW_COL2: <-.3, <-.4, A.3, A.4, B.3, B.4, C.3, C.4, MOD.3, MOD.4, U301.11
/Sheet5FA23F01/SW_COL3: 0.3, 0.4, 1.3, 1.4, 4.3, 4.4, 7.3, 7.4, D.3, D.4, U301.12
/Sheet5FA23F01/SW_COL4: 2.3, 2.4, 5.3, 5.4, 8.3, 8.4, ..3, ..4, E.3, E.4, U301.13
/Sheet5FA23F01/SW_COL5: 3.3, 3.4, 6.3, 6.4, 9.3, 9.4, F.3, F.4, U301.14
/Sheet5FA23F01/SW_COL6: +.3, +.4, -.3, -.4, /.3, /.4, ENTER.3, ENTER.4, U301.15, X.3, X.4
/Sheet5FA23F01/SW_ROW1: 1.1, 1.2, 2.1, 2.2, 3.1, 3.2, +.1, +.2, MOD.1, MOD.2, PASTE.1, PASTE.2, U301.7, X-Y.1, X-Y.2
/Sheet5FA23F01/SW_ROW2: 4.1, 4.2, 5.1, 5.2, 6.1, 6.2, -.1, -.2, A.1, A.2, COPY.1, COPY.2, ROL.1, ROL.2, U301.6
/Sheet5FA23F01/SW_ROW3: 7.1, 7.2, 8.1, 8.2, 9.1, 9.2, B.1, B.2, CHS.1, CHS.2, SEND.1, SEND.2, U301.5, X.1, X.2
/Sheet5FA23F01/SW_ROW4: /.1, /.2, BASE.1, BASE.2, C.1, C.2, D.1, D.2, DSP.1, DSP.2, E.1, E.2, F.1, F.2, U301.4
BATT_PG: R501.1, U401.18, U501.7
BATT_STAT1: R503.1, U401.20, U501.3
BATT_STAT2: R502.1, U401.19, U501.4
BUTTON_DN: R508.2, U401.25
GND: C201.2, C202.2, C203.2, C204.2, C205.2, C206.2, C207.2, C208.2, C209.2, C210.2, C213.2, C214.2, C215.2, C216.2, C301.2, C401.2, C402.2, C403.2, C404.2, C405.2, C406.2, C407.2, C408.2, C409.2, C410.2, C411.2, C412.2, C413.2, C414.2, C415.2, C416.2, C417.2, C418.2, C419.2, C420.2, C501.2, C502.2, C503.2, C504.2, C506.2, C507.2, C508.2, C509.2, H201.1, H202.1, H203.1, H204.1, H401.1, H402.1, H403.1, H404.1, J201.1, J202.1, J203.1, J204.1, J401.1, J402.1, J403.1, J404.1, J405.6, J406.5, J406.6, J407.5, J407.6, J501.2, J502.2, Q502.2, R401.2, R411.2, R423.2, R424.2, R426.2, R504.1, R507.1, R511.1, R513.1, RV401.1, SW501.1, SW501.3, SW501.4, TH501.2, U1.6, U1.20, U1.25, U2.20, U2.25, U3.20, U3.25, U4.6, U4.20, U4.25, U5.20, U5.25, U6.20, U6.25, U301.19, U301.25, U401.8, U401.23, U401.35, U401.47, U402.4, U403.4, U404.6, U404.16, U405.4, U501.5, U501.11, U502.2
I2C1_SCL: J401.2, R404.1, U301.23, U401.42
I2C1_SDA: J401.3, R402.1, U301.22, U401.43
I2C_SCL_A: J201.2, U1.2, U2.2, U3.2, U3.6
I2C_SCL_B: J202.2, U4.2, U5.2, U6.2, U6.6
I2C_SDA_A: J201.3, U1.1, U2.1, U3.1
I2C_SDA_B: J202.3, U4.1, U5.1, U6.1
KEYBD_INT: R302.1, U301.24, U401.31
KEYBD_RST: R301.1, U301.20, U401.30
unnamed: C505.2, C506.1, R512.1, R513.2, U502.4
unnamed: D1.1, R205.1
unnamed: D2.1, R206.1
unnamed: D3.1, R207.1
unnamed: D4.1, R208.1
unnamed: D401.1, R410.1
unnamed: D402.1, U404.10
unnamed: D402.2, R419.1
unnamed: D403.1, U404.17
unnamed: D403.2, R420.1
unnamed: D501.1, R505.2, R506.1, SW501.2
unnamed: D501.2, J502.1, Q502.3, R509.2
unnamed: F401.2, J406.1
unnamed: F402.2, J407.1
unnamed: J406.2, R408.1
unnamed: J406.3, R409.1
unnamed: J406.4, R411.1
unnamed: J407.2, R421.1
unnamed: J407.3, R422.1
unnamed: J407.4, R423.1
unnamed: L501.1, U502.5
unnamed: Q501.1, R505.1
unnamed: Q501.3, R507.2, R508.1
unnamed: Q502.1, R510.1
unnamed: Q503.2, R509.1
unnamed: R303.2, U301.18
unnamed: R304.2, U301.1
unnamed: R305.2, U301.17
unnamed: R306.2, U301.2
unnamed: R307.2, U301.16
unnamed: R308.2, U301.3
unnamed: R401.1, U401.44
unnamed: R413.1, R415.2, U405.1
unnamed: R414.1, R416.2, U405.7
unnamed: R415.1, R417.2, U405.2
unnamed: R416.1, R418.2, U405.6
unnamed: R421.2, U404.12
unnamed: R422.2, U404.11
unnamed: R424.1, R425.2, U405.3
unnamed: R426.1, R427.2, U405.5
unnamed: R504.2, U501.6
unnamed: TP403.1, U401.4
unnamed: TP404.1, U401.29
PWR_HOLD: R510.2, U401.28
USBVBUS: C501.1, C502.1, F401.1, R417.1, U501.1, U501.2
VBATT_RAW: C503.1, C504.1, C507.1, J501.1, Q503.1, R418.1, R506.2, U501.9, U501.10, U502.1
