jay-hamlin/rpncalculator/Software/Core/Src/main.c

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
/* Includes ------------------------------------------------------------------*/
#include "main.h"

/* USER CODE BEGIN Includes */
#include <stdio.h>
#include "rpnHwDefs.h"
#include "display.h"
#include "keypad.h"
#include "calcMaths.h"
#include "calculator.h"

/* USER CODE END Includes */

ADC_HandleTypeDef hadc;

I2C_HandleTypeDef hi2c1;
I2C_HandleTypeDef hi2c2;

IWDG_HandleTypeDef hiwdg;

TIM_HandleTypeDef htim1;
TIM_HandleTypeDef htim3;

UART_HandleTypeDef huart2;

PCD_HandleTypeDef hpcd_USB_FS;

void SystemClock_Config(void);
static void MX_GPIO_Init(void);
static void MX_ADC_Init(void);
static void MX_I2C1_Init(void);
static void MX_I2C2_Init(void);
static void MX_TIM1_Init(void);
static void MX_TIM3_Init(void);
static void MX_USART2_UART_Init(void);
static void MX_USB_PCD_Init(void);
static void MX_IWDG_Init(void);
/* USER CODE BEGIN PFP */
static void StartADCs(void);
static void HandleLEDBlinker(int16_t tick);

#define    UART_QUEUE_SIZE    16
uint8_t    uart_rx_data[4];

uint8_t    uartcharqueue[UART_QUEUE_SIZE];
int16_t    uartqueueHead;
int16_t    uartqueueTail;
void    PushUARTQueue(uint8_t    value);
uint8_t    PopUARTQueue(void);

/* USER CODE END PFP */

/* USER CODE BEGIN 0 */
int16_t            adcValues[ADC_CHANNEL_COUNT];
static int16_t     adcChannel;
static char     pwrButtonEnabled;

/* USER CODE END 0 */

/**
  * @brief  The application entry point.
  * @retval int
  */
int main(void)
{
  /* USER CODE BEGIN 1 */
    int16_t        i,ticker;
     uint8_t        keycode;

  /* USER CODE END 1 */

  /* MCU Configuration--------------------------------------------------------*/

  /* Reset of all peripherals, Initializes the Flash interface and the Systick. */
  HAL_Init();

  /* Configure the system clock */
  SystemClock_Config();

  /* Initialize all configured peripherals */
  MX_GPIO_Init();
  MX_ADC_Init();
  MX_I2C1_Init();
  MX_I2C2_Init();
  MX_TIM1_Init();
  MX_TIM3_Init();
  MX_USART2_UART_Init();
  MX_USB_PCD_Init();
  MX_IWDG_Init();
  /* USER CODE BEGIN 2 */
    POWER_SUPPLY_HOLD(1);  // hold the power supply on
    KEYPAD_RESET(1);          // hold keypad in reset

    HAL_TIM_Base_Start(&htim1);

     HAL_IWDG_Refresh(&hiwdg);  // kick WDT

     DisplayInitialize();
     HAL_IWDG_Refresh(&hiwdg);  // kick WDT

     KeyboardInitialize();
     DoInitializeCalculator();

     i=0;
     while(i<ADC_CHANNEL_COUNT){
         adcValues[i++]=0;
     }

          pwrButtonEnabled=0;

       ticker = 0;
#if 1
            HAL_UART_Transmit(&huart2,(uint8_t *)"BOOTED\n\r",8, 1000);
#endif

  /* USER CODE END 2 */

  /* Infinite loop */
  /* USER CODE BEGIN WHILE */
  while (1)
  {
      HAL_IWDG_Refresh(&hiwdg);  // kick WDT
      HAL_PWR_EnterSLEEPMode( PWR_LOWPOWERREGULATOR_ON, PWR_SLEEPENTRY_WFI );      // sleep 1ms

    /* USER CODE END WHILE */

    /* USER CODE BEGIN 3 */

      keycode = ReadKeypad(); // check for new key codes
      if(pwrButtonEnabled==0){
          if(keycode==KEY_PWR_ON_OFF){  // button released, we can enable the ON/OFF function
              pwrButtonEnabled=1;
          }
      } else {
          if(keycode==(KEYDOWN_EVENT|KEY_PWR_ON_OFF)){  // button pressed
              POWER_SUPPLY_HOLD(0);  // turn the power supply off
          }
      }

      if(ticker==0)
          StartADCs();

      HandleLEDBlinker(ticker);

      (void)PopUARTQueue();


      DoRunCalculator(keycode);

      ticker++;
       if(ticker == 1000)
          ticker =0;
  }
  /* USER CODE END 3 */
}

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
/* USER CODE BEGIN 4 */

static void HandleLEDBlinker(int16_t tick)
{
#if 1
    // blink LED
     if(tick==75)
         LED(0); // LED off
     else if(tick==0)
         LED(1); // LED on
#endif
}

// The ADC  reads ADC4, ADC5 and ADC6
// MonitorADCs gets called @ 4ms interval
//  - ADC conversion starts every 8ms
//  - a result happens every 8ms
//  - so a new reading happens every 16ms.
static void StartADCs(void)
{

    HAL_ADC_Start_IT(&hadc);
    adcChannel=0;
    // when channrl==4 we know all the channels have been read

}

void HAL_ADC_ConvCpltCallback(ADC_HandleTypeDef* phadc)
{
    int32_t  adc;

    // Read & Update The ADC Result
    adc = (int32_t)HAL_ADC_GetValue(phadc );
    if (adcChannel<ADC_CHANNEL_COUNT){
         adcValues[adcChannel] = adc;
         adcChannel++;
         if(adcChannel==ADC_CHANNEL_COUNT){
             HAL_ADC_Stop(phadc);
         }
    }

}

void HAL_UART_RxCpltCallback(UART_HandleTypeDef *huart)
{

     HAL_UART_Receive_IT(&huart2,uart_rx_data,1);
     PushUARTQueue(uart_rx_data[0]);

}



/*    **    **    **    **    **    **    **    **    **    **    **    **    **    **    **    **    **    **    **
 *     PushKeyEventQueue - reads a 1 byte register from the TCA8414
 *  INPUT: value (keycode) to stuff onto the queue
 *  OUTPUT: none
 *  **    **    **    **    **    **    **    **    **    **    **    **    **    **    **    **    **    **    */
void    PushUARTQueue(uint8_t    value)
{
    uartcharqueue[uartqueueHead]=value;
    uartqueueHead++;
    if(uartqueueHead==UART_QUEUE_SIZE)
        uartqueueHead=0;

    if(uartqueueHead == uartqueueTail){
        // the queue is now full

    }

}

/*    **    **    **    **    **    **    **    **    **    **    **    **    **    **    **    **    **    **    **
 *     PopKeyEventQueue - reads a 1 byte register from the TCA8414
 *  INPUT:  none
 *  OUTPUT: value (keycode) from the queue or zero if queue is empty
 *  **    **    **    **    **    **    **    **    **    **    **    **    **    **    **    **    **    **    */
uint8_t    PopUARTQueue(void)
{
    uint8_t value;

    if(uartqueueHead == uartqueueTail){
        // the queue is empty
        value =0;
    } else {
        value = uartcharqueue[uartqueueTail];
        uartqueueTail++;
        if(uartqueueTail==UART_QUEUE_SIZE)
            uartqueueTail=0;
    }

    return(value);
}


/* USER CODE END 4 */
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
