jay-hamlin/rpncalculator/Software/Core/Inc/charMatrix.h

/*
 * charMatrix.h
 *
 *  Created on: Nov 27, 2020
 *      Author: jayhamlin
 */

/*    **    **    **    **    **    **    **    **    **    **    **    **    **    **    **    **    **    **    **
* This data was lifted from the Pimoroni Ltd. microdotphat python library font.py file downloaded from gitHub
* font.py came with The MIT License.
*
* This is the character array for a 5x7 dot matrix display.
*   1- Each character consists of 5 bytes (one for each column).
*   2- Each bit is a pixel, with bit 0 as row 1 at the top of the display and bit 6 at the bottom.
*
*  **    **    **    **    **    **    **    **    **    **    **    **    **    **    **    **    **    **    */


#ifndef INC_CHARMATRIX_H_
#define INC_CHARMATRIX_H_

#define	BYTES_PER_CHAR			5
#define	ASCII_START				32
#define	ASCII_END				156
#define	ASCII_ARRAY_SIZE		(BYTES_PER_CHAR*(ASCII_END-ASCII_START+1))

uint8_t asciiFont[ASCII_ARRAY_SIZE] = {
    0x00, 0x00, 0x00, 0x00, 0x00, // 32 (space)
    0x00, 0x00, 0x5f, 0x00, 0x00, // 33 !
    0x00, 0x07, 0x00, 0x07, 0x00, // 34 "
    0x14, 0x7f, 0x14, 0x7f, 0x14, // 35 #
    0x24, 0x2a, 0x7f, 0x2a, 0x12, // 36 $
    0x23, 0x13, 0x08, 0x64, 0x62, // 37 %
    0x36, 0x49, 0x55, 0x22, 0x50, // 38 &
    0x00, 0x05, 0x03, 0x00, 0x00, // 39 '
    0x00, 0x1c, 0x22, 0x41, 0x00, // 40 (
    0x00, 0x41, 0x22, 0x1c, 0x00, // 41 )
    0x08, 0x2a, 0x1c, 0x2a, 0x08, // 42 *
    0x08, 0x08, 0x3e, 0x08, 0x08, // 43 +
    0x00, 0x50, 0x30, 0x00, 0x00, // 44 ,
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
	0x00, 0x00, 0x00, 0x00, 0x00, // 128
	0x00, 0x00, 0x00, 0x00, 0x00, // 129
    0x00, 0x07, 0x00, 0x07, 0x00, // 130 ”
    0x08, 0x1C, 0x2A, 0x08, 0x08, // 131 ←
    0x08, 0x04, 0x7E, 0x04, 0x08, // 132 ↑
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
	0x00, 0x00, 0x00, 0x00, 0x00  // 156 END
};


#endif /* INC_CHARMATRIX_H_ */
