jay-hamlin/rpncalculator/Software/Core/Inc/calcTrig.h

/*
 * calctrig.h
 *
 *  Created on: Dec 23, 2020
 *      Author: jayhamlin
 */

#ifndef INC_CALCTRIG_H_
#define INC_CALCTRIG_H_

// pi = 3.14159265358979323846264338327950288419716939937510
extern  const   decimal_t    pi;


void    CalcRadToDegrees(decimal_t *deg,decimal_t *rad);
void    CalcDegreesToRad(decimal_t *rad,decimal_t *deg);



#endif /* INC_CALCTRIG_H_ */
