jay-hamlin/rpncalculator/(commit log)

2020-12-23 First checkin Hardware
    [MCU.sch, Power Supply.sch, RPNCalc_BOM_1208.ods, RPN_Calc.kicad_pcb, RPN_calc_TOPsch.sch, display.sch, keyboard.sch]
2020-12-23 First checkin Software
    [rpnkeys.scad, rpnkeys2.scad]
2020-12-29 adding STM32CubeIDE project file
2021-01-01 Adding latest keyboard design
    [rpnkeys_1230am.scad, rpnkeys_frame.scad]
2021-01-01 fix bug in divide. result exp to int16_t
    [calcMaths.c, calcUtilities.c, calcUtilities.h, keyFunctions.c]
2021-01-03 more stack fixes, NAN in divide works,Modulo
    [calcMaths.c, calcMaths.h, calculator.c, display.c, display.h, keyFunctions.c, main.c]
